speters/Carson-U300-alternative-controller/Carson Unimog Steuerplatine top.png

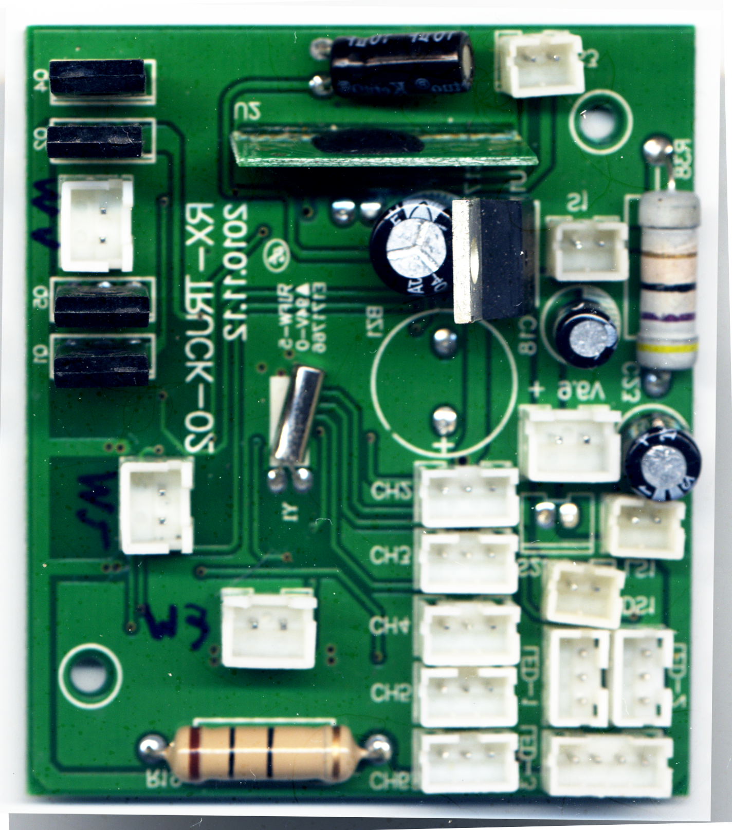
Carson Unimog Steuerplatine top.png
