speters/Carson-U300-alternative-controller/IMG_3559_1280.jpg

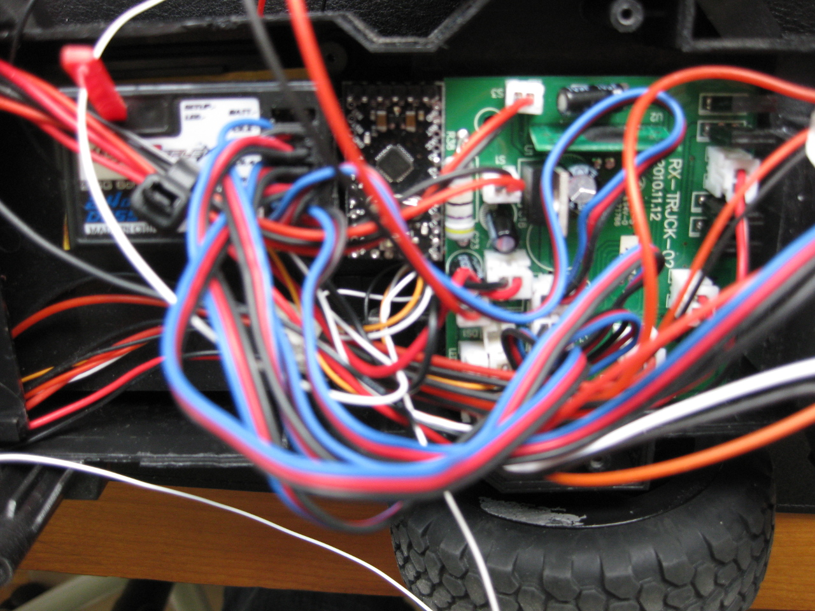
IMG_3559_1280.jpg
