speters/Carson-U300-alternative-controller/IMG_3560_1280.jpg

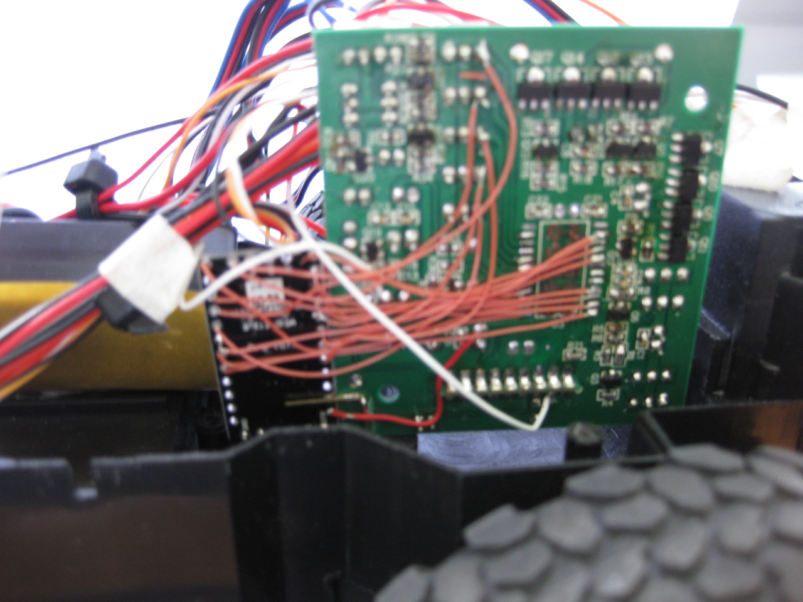
IMG_3560_1280.jpg
