speters/Carson-U300-alternative-controller/Carson Unimog Steuerplatine Belegung.ods

Sheet: Steckerbelegungen
Steckplatz | Funktion | Belegung
M1 | Motor Antrieb | 1:bk, 2:rd
M2 | Motor Kipper | 1:bk, 2: rd | unbeschriftet, neben Q1
M3 | Motor Winde/Schneeschild | 1:bk, 2: rd | unbeschriftet, zwischen Y1 und R19; über Schalter DPDT zur Funktionsumschaltung am Modell
LED-1 | Licht hinten links | 1:bk, 2: or, 3: wt
LED-2 | Licht hinten rechts | 1:bk, 2: or, 3: wt
LED-3 | Licht vorne | 1:bk, 2: or, 3: wt, 4: rd | bk, wt: vorne re; or, rd: vorne li
DS1 | Blinklicht Kabine | 1:bk, 2: rd
LS1 | Speaker | 1:bk, 2: rd
S1 | Schalter Speaker on/off | 1:bk, 2: rd
S3 | Schalter Alert Sound on/off | 1:bk, 2: rd | piept bei Rückwärtsfahrt
+ 9.6V | Akku | 1:bk, 2: rd
CH2 | Servosignal Antriebsmotor | 1:bk, 2:rd, 3:bl | Stick links vor/zurück
CH3 | Servosignal Winde | 1:bk, 2:rd, 3:bl | Stick links re: ausfahren, li: einfahren
CH4 | Servosignal Kipper | 1:bk, 2:rd, 3:bl | Stick rechts oben/unten, bewegt sich ca. alle 12s für 2s, wenn kein Servosignal anliegt
CH5 | Servosignal Hupe | 1:bk, 2:rd, 3:bl | (1)-0-(1) Kipptaster links oben an Hupe
CH6 | Servosignal Licht an/aus | 1:bk, 2:rd, 3:bl | 1-0-1 Kippschalter rechts oben an Funke

Sheet: EM78P54N
 | EM78P540N |  |  | Arduino
1 | Motor Antrieb PWM 1 | out | aktiv bei Rückwärtsfahrt | 5
2 | Motor Antrieb PWM 2 | out | aktiv bei Vorwärtsfahrt | 6
3 | Rückwärtsfahrtsignal | out | verzögert (~1s) aktiv bei Rückwärtsfahrt über S3 an Soundmodul Pin16 | A0
4 | Hupe | out |  | 3
5 | VDD +5V
6 | PLLC?
7 | VSS GND
8 | Rückfahrlicht |  | ? | 10
9 | Licht | out |  | 9
10 | Blinksequenz | out |  | 13
11 | ? |  | an Soundmodul Pin17 | 4
12 | XTAL in
13 | XTAL out
14 | CH2 Servosignal | in |  | A1
15 | CH6 Servosignal | in |  | A5
16 | CH5 Servosignal | in |  | A4
17 | CH4 Servosignal | in |  | A3
18 | CH3 Servosignal | in |  | A2
20 | - |  | unused, an (R36/unbestückt) für Buzzerschaltung (unbestückt)
21 | Motor Kipper PWM1 | out |  | 11
22 | Motor Kipper PWM2 | out |  | 7
23 | Motor Winde PWM 1 | out |  | 2
24 | Motor Winde PWM 2 | out |  | 12
 | CH1 (direkt an Servo) |  |  | A6
 | Lenkungsservo |  |  | 8

Sheet: Component-ID
Silk | Marking | Typ | Gehäuse | Vergleichstyp | Belegung
Q17 | D882 | NPN | SOT89 | 2SD882 | 1: B, 2: C, 3: E
Q16 | D882 | NPN | SOT89 | 2SD882 | 1: B, 2: C, 3: E
Q10 | D882 | NPN | SOT89 | 2SD882 | 1: B, 2: C, 3: E
Q11 | D882 | NPN | SOT89 | 2SD882 | 1: B, 2: C, 3: E
Q14 | B772 | PNP | SOT89 | 2SB772 | 1: B, 2: C, 3: E
Q13 | B772 | PNP | SOT89 | 2SB772 | 1: B, 2: C, 3: E
Q7 | B772 | PNP | SOT89 | 2SB772 | 1: B, 2: C, 3: E
Q8 | B772 | PNP | SOT89 | 2SB772 | 1: B, 2: C, 3: E
Q15 | BDC | NPN | SOT23 | S9014, BC550 | 1: B; 2: E, 3: C
Q18 | BDC | NPN | SOT23 | S9014, BC550 | 1: B; 2: E, 3: C
Q9 | BDC | NPN | SOT23 | S9014, BC550 | 1: B; 2: E, 3: C
Q12 | BDC | NPN | SOT23 | S9014, BC550 | 1: B; 2: E, 3: C
Q6 | BDC | NPN | SOT23 | S9014, BC550 | 1: B; 2: E, 3: C
Q3 | BDC | NPN | SOT23 | S9014, BC550 | 1: B; 2: E, 3: C
Q20 | BHD | NPN | SOT23 |  | 1: B; 2: E, 3: C
Q22 | BHD | NPN | SOT23 |  | 1: B; 2: E, 3: C
Y1 |  | 32,768kHz | 3zyl. .1mm*8mm
R19 |  | 10Ohm, 2W
R38 |  | 41Ohm, 2W
Q1 | B196 | PNP | TO126, SOT32 | BD140 ? | 1: B, 2: C, 3: E
Q2 | B196 | PNP | TO126, SOT32 | BD140 ? | 1: B, 2: C, 3: E
Q4 | D195 | NPN | TO126, SOT32 | BD139 ? | 1: B, 2: C, 3: E
Q5 | D195 | NPN | TO126, SOT32 | BD139 ? | 1: B, 2: C, 3: E
