speters/Carson-U300-alternative-controller/(commit log)

2015-09-03 initial import
    [Carson Unimog Steuerplatine Belegung.ods]
2015-09-10 Added link to RC-Forum.de thread
2015-09-18 Added sound, omitted original sound module
    [Carson Unimog Steuerplatine Belegung.ods]
2015-09-19 Pinout changes
    [Carson Unimog Steuerplatine Belegung.ods]
2015-10-09 Mute sound via serial console, pin changes reflecting the actual hardware connections
2015-10-09 Pin changes reflecting the actual hardware connections
    [Carson Unimog Steuerplatine Belegung.ods]
2015-11-10 Arduino version changed to 1.6.7(dev), Arduino-Makefile update
2015-11-10 Motor1 pins exchanged to match speed variable and warning lights
2015-11-13 pin redefs., blinking coupled to headlight switch
